MNDJ777/HDMI2EL/hardware/实物仿真图 (2).png

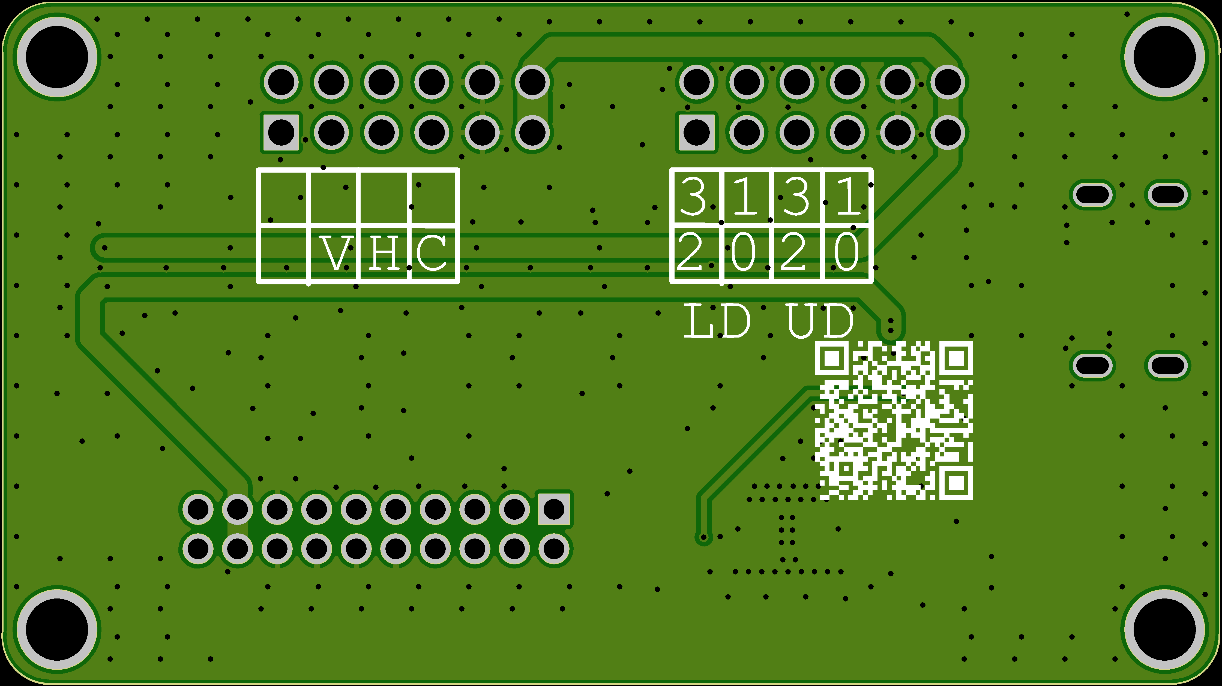
hardware/实物仿真图 (2).png
