MNDJ777/HDMI2EL/pics/85dafd000485e3890ad1b6b6e363102.jpg

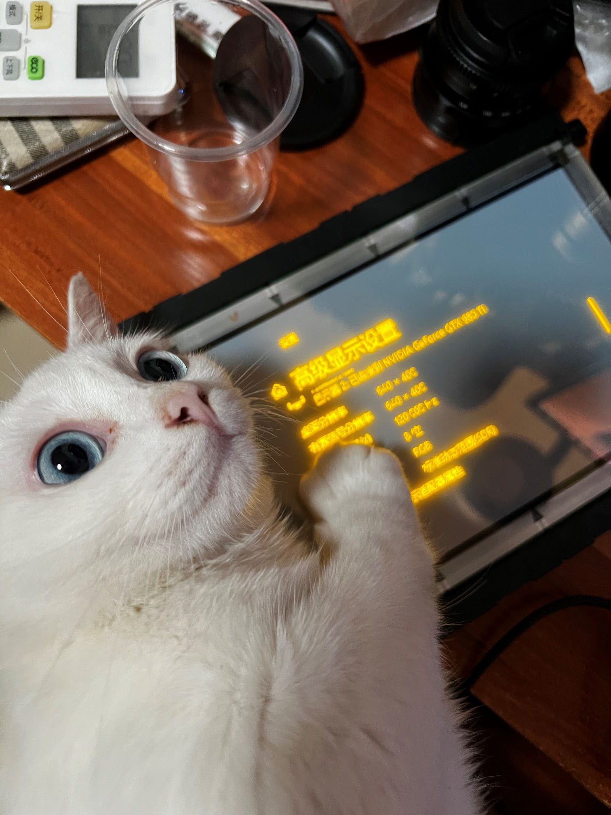
pics/85dafd000485e3890ad1b6b6e363102.jpg
