MNDJ777/HDMI2EL/pics/CON16.jpg

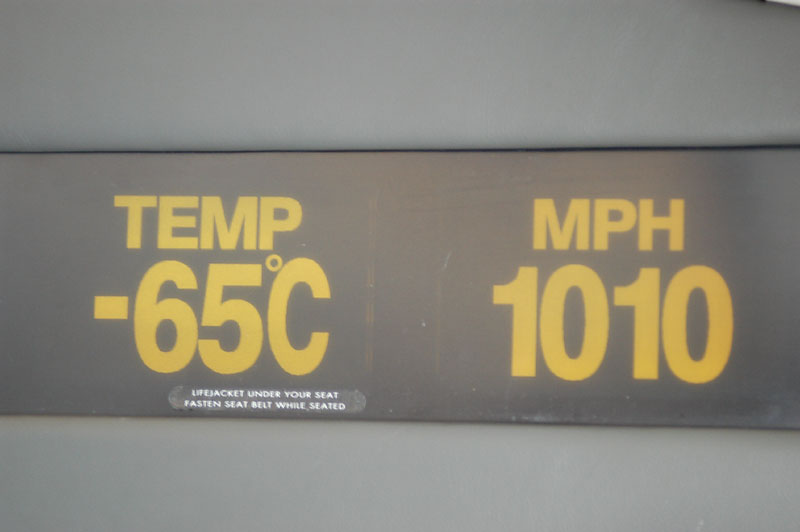
pics/CON16.jpg
