MNDJ777/HDMI2EL/pics/CON22.jpg

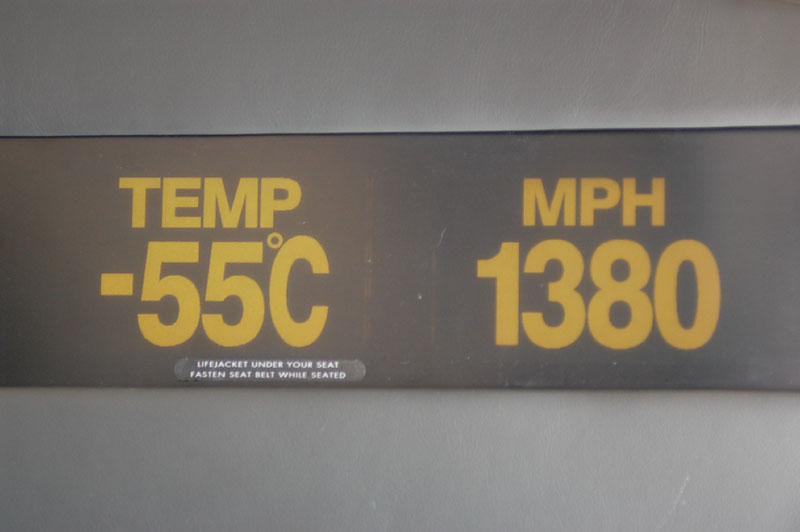
pics/CON22.jpg
