MNDJ777/HDMI2EL/pics/CON24.jpg

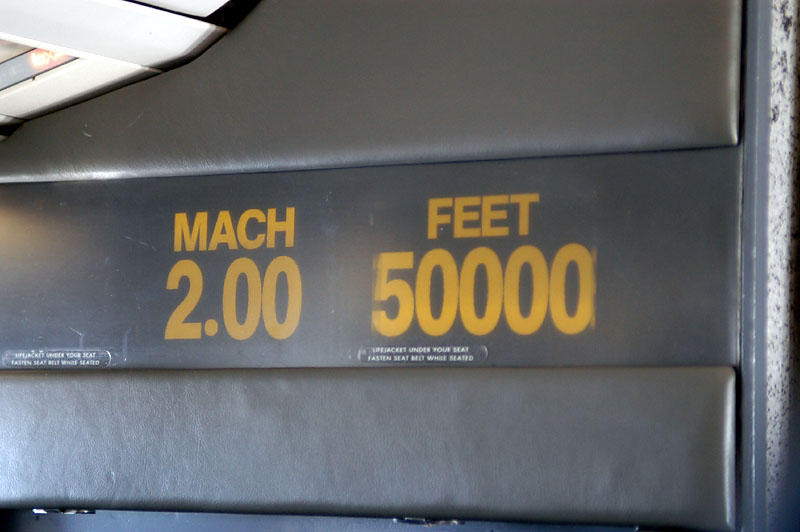
pics/CON24.jpg
