MNDJ777/HDMI2EL/pics/display.jpg

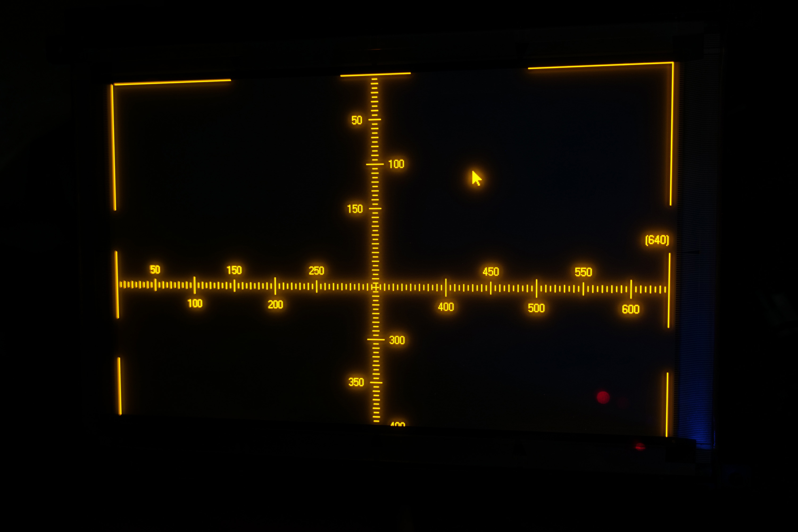
pics/display.jpg
