MNDJ777/HDMI2EL/pics/Fast-Free-Ship-ZedBoard-development-board-ZYNQ7000-development-board-XILINX-FPGA-Demo-Board.webp

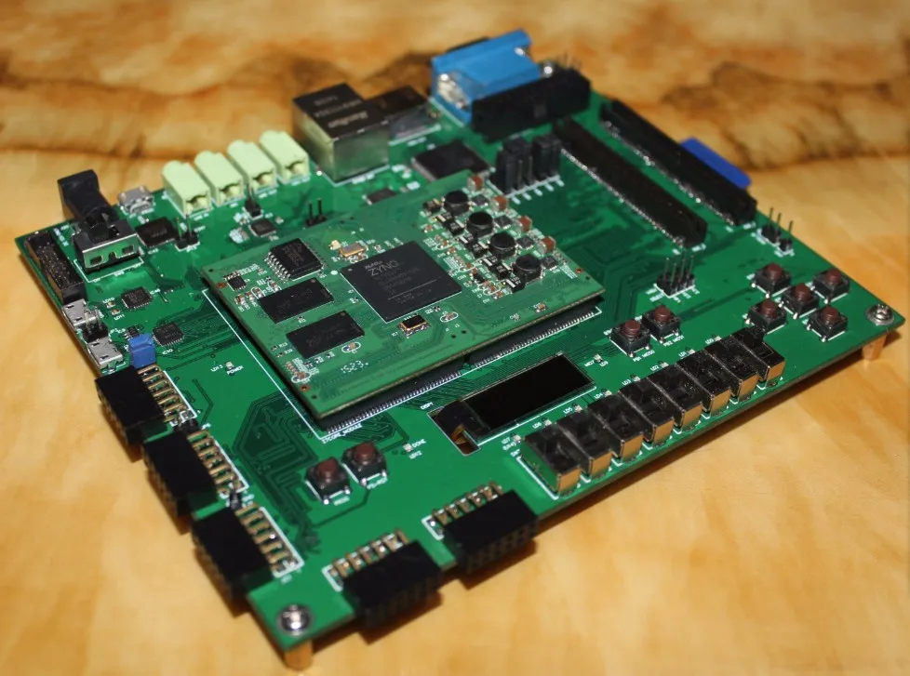
pics/Fast-Free-Ship-ZedBoard-development-board-ZYNQ7000-development-board-XILINX-FPGA-Demo-Board.webp
