MNDJ777/HDMI2EL/pics/R.jpg

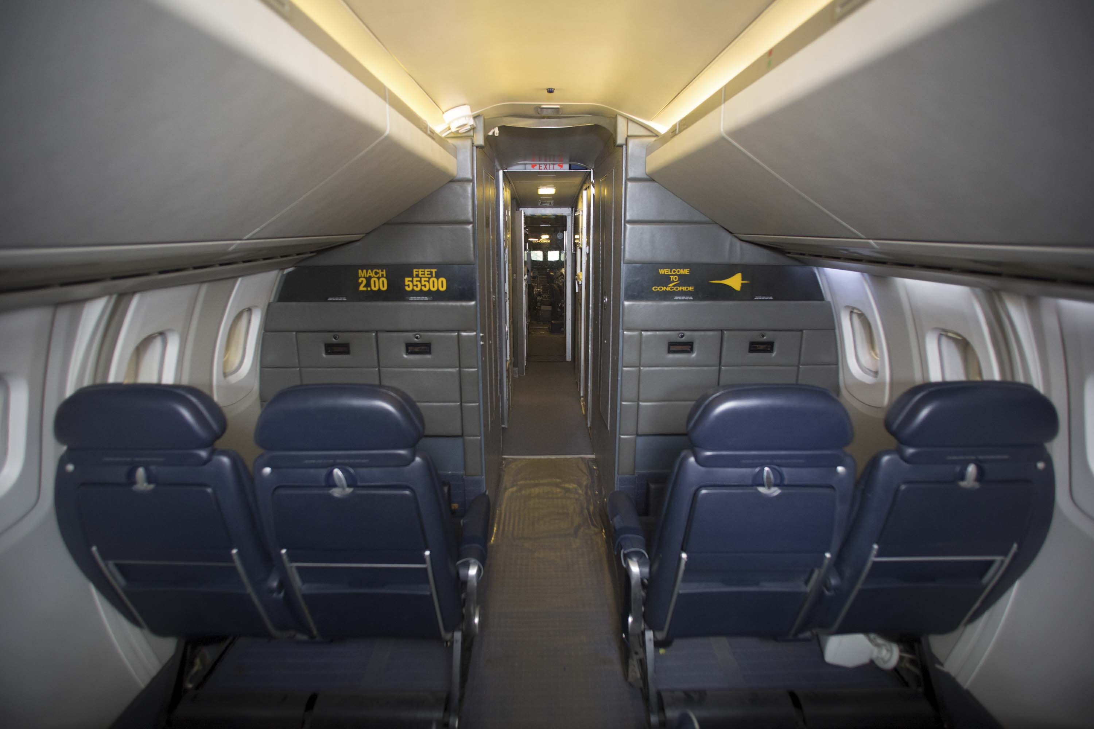
pics/R.jpg
