MNDJ777/HDMI2EL/pics/singalport.jpg

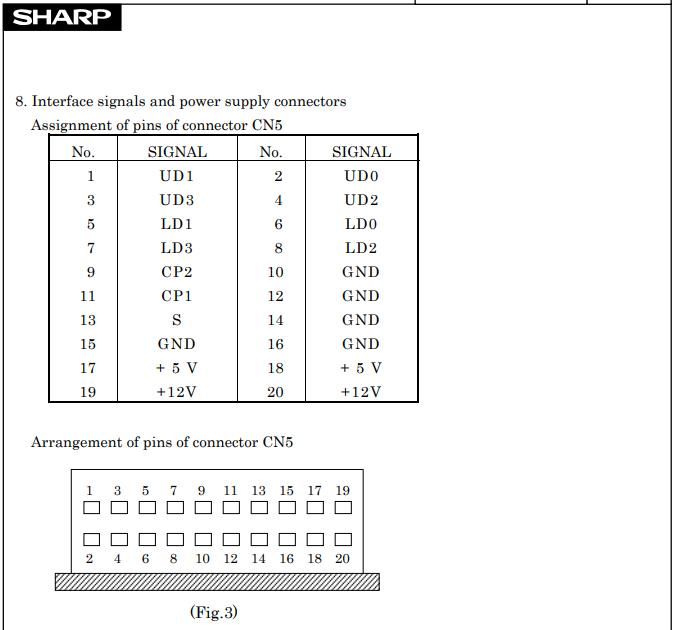
pics/singalport.jpg
