MNDJ777/HDMI2EL/(list of files, drawings)

Other design files:
hardware/ProProject_EL_Driver_2024-06-29.epro
